OftenMissYi/Underwater-Robot-STM32F429/docs/project-presentation.pdf

# 水下四旋浆机器人

答辩人：赵珈毅 | 指导老师：刘富樯

2024

### 机器人工程专业

专业：机器人工程

组长：洪伟煌 组员：赵珈毅 罗成富 邢树超 夏威

C O N T A N T S

目 录

01 选题背景和意义 | 02 机器人结构设计
03 机器人电控系统设计 | 04 成果展示与未来展望

# 01 选题背景和意义

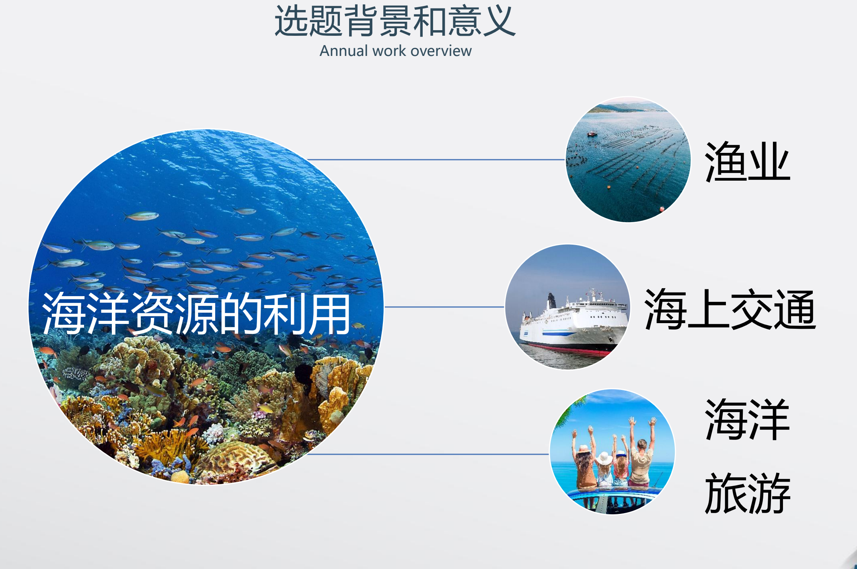
[picture p23: figure]
选题背景和意义; Annual work overview; 海洋资源的利用; 海上交通
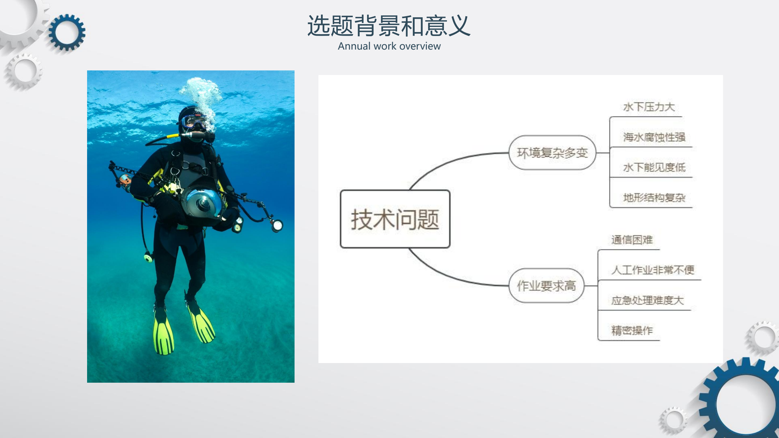
[picture p24: page 5]

选题背景和意义

Annual work overview

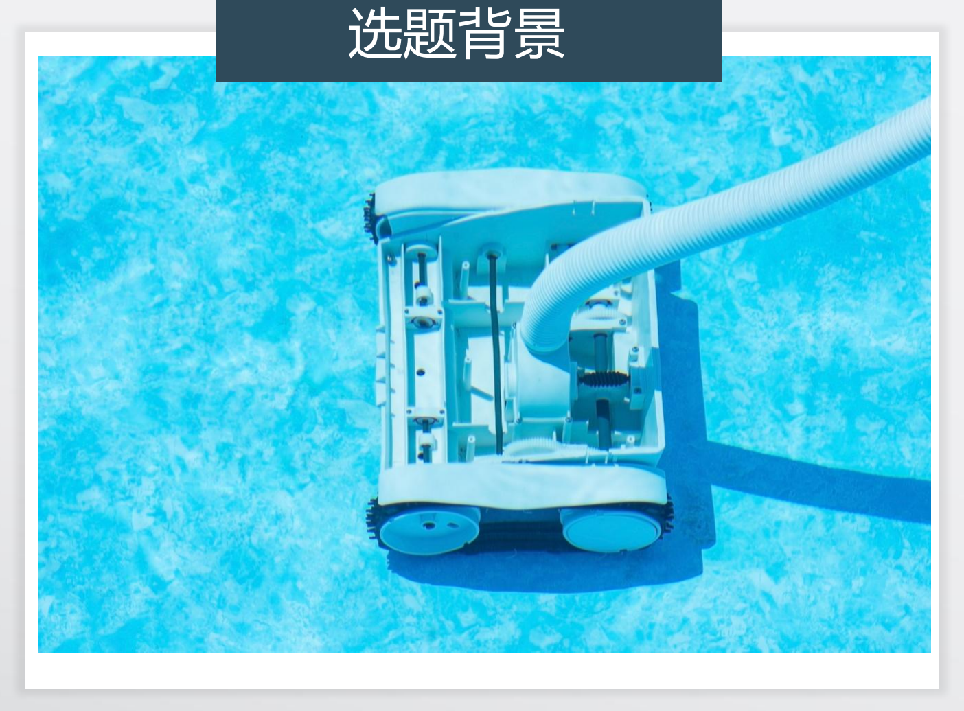
[picture p25: figure]
选题背景

小型水下机器人是一种用于水下极
限作业的机器人，具备在狭小空间
内灵活作业的能力。

因此，小型水下机器人在人机协同
作业、复杂环境勘探、水下集群作
业等方面具有充分优势。

选题背景和意义

Annual work overview

本组旨在开发一种小型拖缆式水下
机器人，以应对海下环境复杂多变
对水下作业提出的诸多挑战。

小型拖缆式水下机器人结合了自主
导航和拖缆控制技术，具有高度的
灵活性和适应性.

选题背景和意义

Annual work overview
水下机器人所面临的工作环境极为恶劣，这些环境特性对机器人的设计、 制造和维护都提出了严峻的挑战。水下机器人的设计应考虑以下因素：

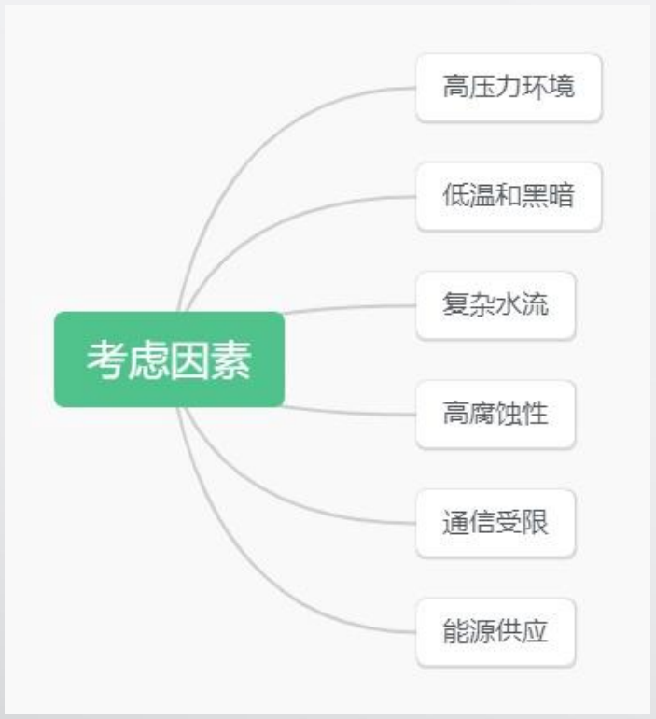
[picture p26: figure]

# 02 机器人结构设计

机器人机构设计

Robot mechanism design

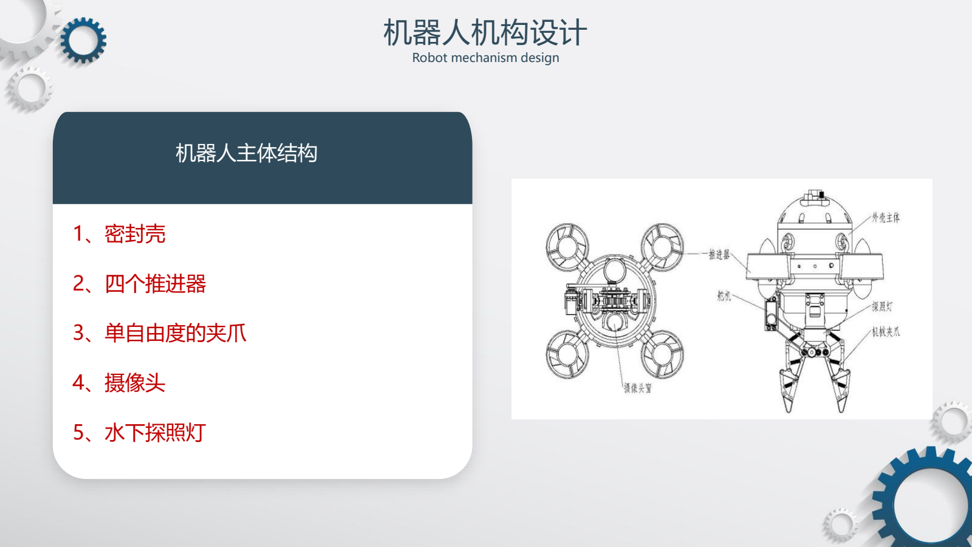
[picture p27: page 10]

机器人主体结构

1、密封壳

2、四个推进器

3、单自由度的夹爪

4、摄像头

5、水下探照灯

添加您的文字内容

机器人机构设计

Robot mechanism design

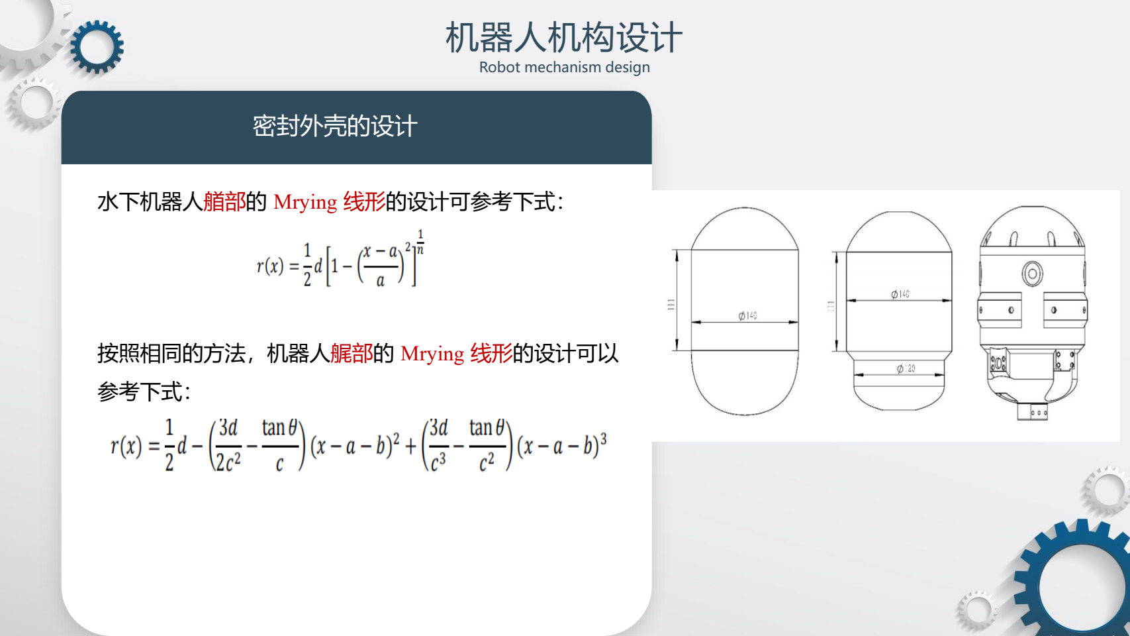
[picture p28: page 11]

密封外壳的设计

水下机器人艏部的 Mrying 线形的设计可参考下式：

按照相同的方法，机器人艉部的 Mrying 线形的设计可以 参考下式：

添加您的文字内容

机器人机构设计

Robot mechanism design

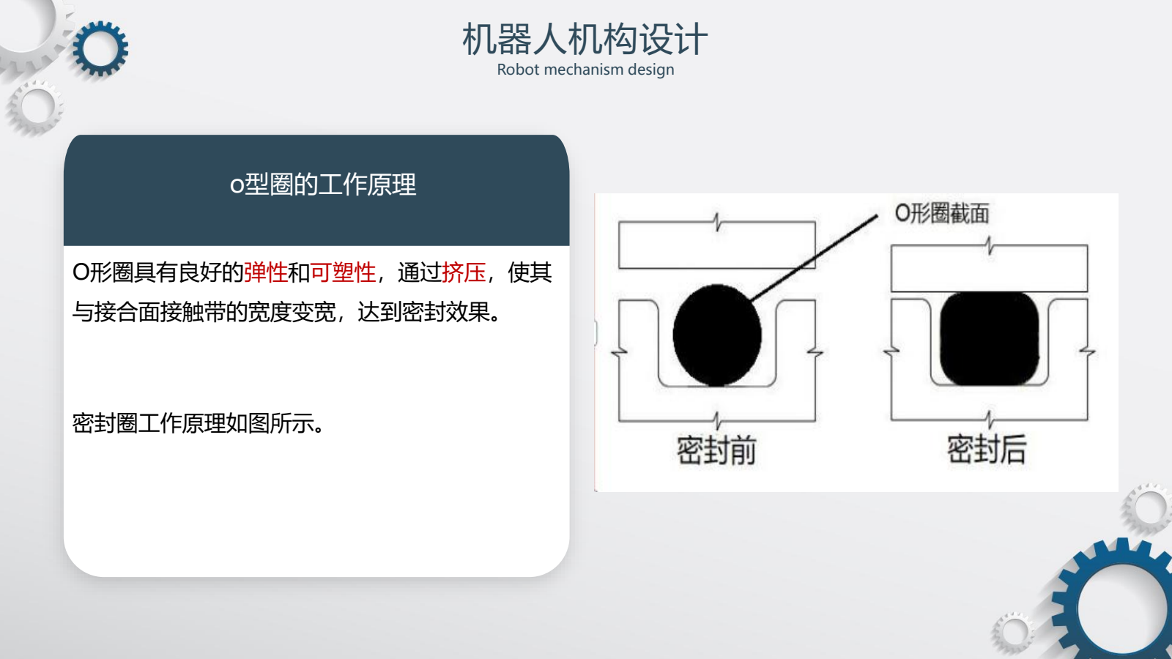
[picture p29: page 12]

o型圈的工作原理

O形圈具有良好的弹性和可塑性，通过挤压，使其
与接合面接触带的宽度变宽，达到密封效果。

密封圈工作原理如图所示。

添加您的文字内容

机器人机构设计

Robot mechanism design

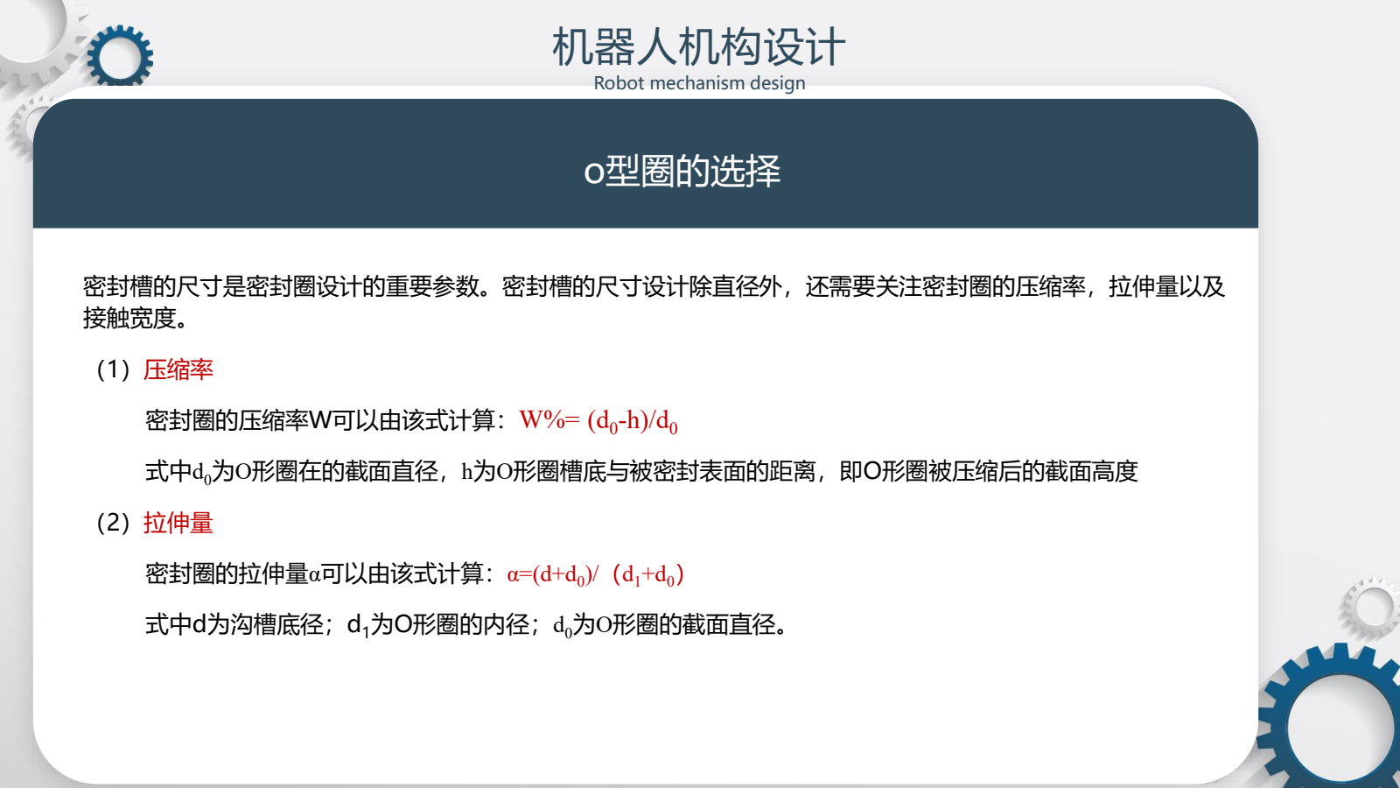
[picture p30: page 13]

o型圈的选择

密封槽的尺寸是密封圈设计的重要参数。密封槽的尺寸设计除直径外，还需要关注密封圈的压缩率，拉伸量以及 接触宽度。

（1）压缩率

密封圈的压缩率W可以由该式计算：W%= (d0
-h)/d0

式中d0为O形圈在的截面直径，h为O形圈槽底与被密封表面的距离，即O形圈被压缩后的截面高度

（2）拉伸量

密封圈的拉伸量α可以由该式计算：α=(d+d0
)/（d1+d0）

式中d为沟槽底径；d1为O形圈的内径；d0为O形圈的截面直径。

机器人机构设计

Robot mechanism design

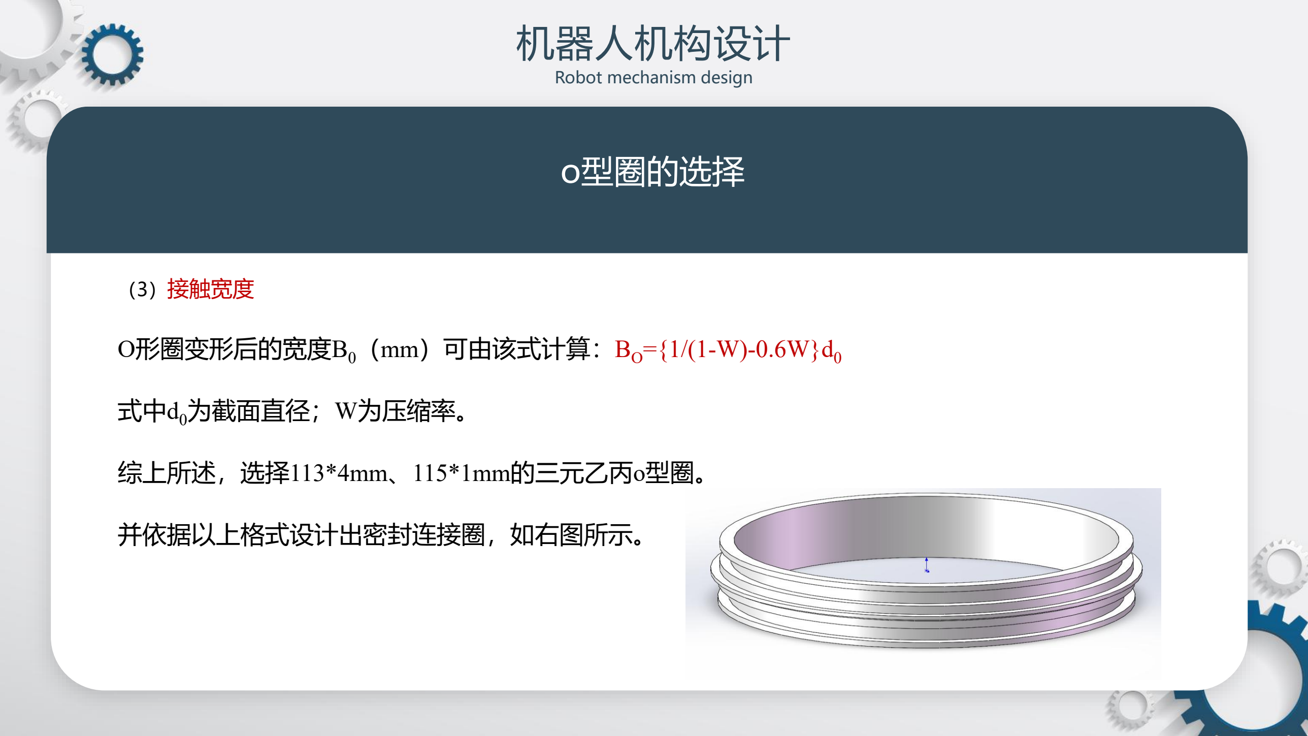
[picture p31: page 14]

o型圈的选择

（3）接触宽度

O形圈变形后的宽度B0（mm）可由该式计算：BO={1/(1-W)-0.6W}d0

式中d0为截面直径；W为压缩率。

综上所述，选择113*4mm、115*1mm的三元乙丙o型圈。

并依据以上格式设计出密封连接圈，如右图所示。

机器人机构设计

Robot mechanism design

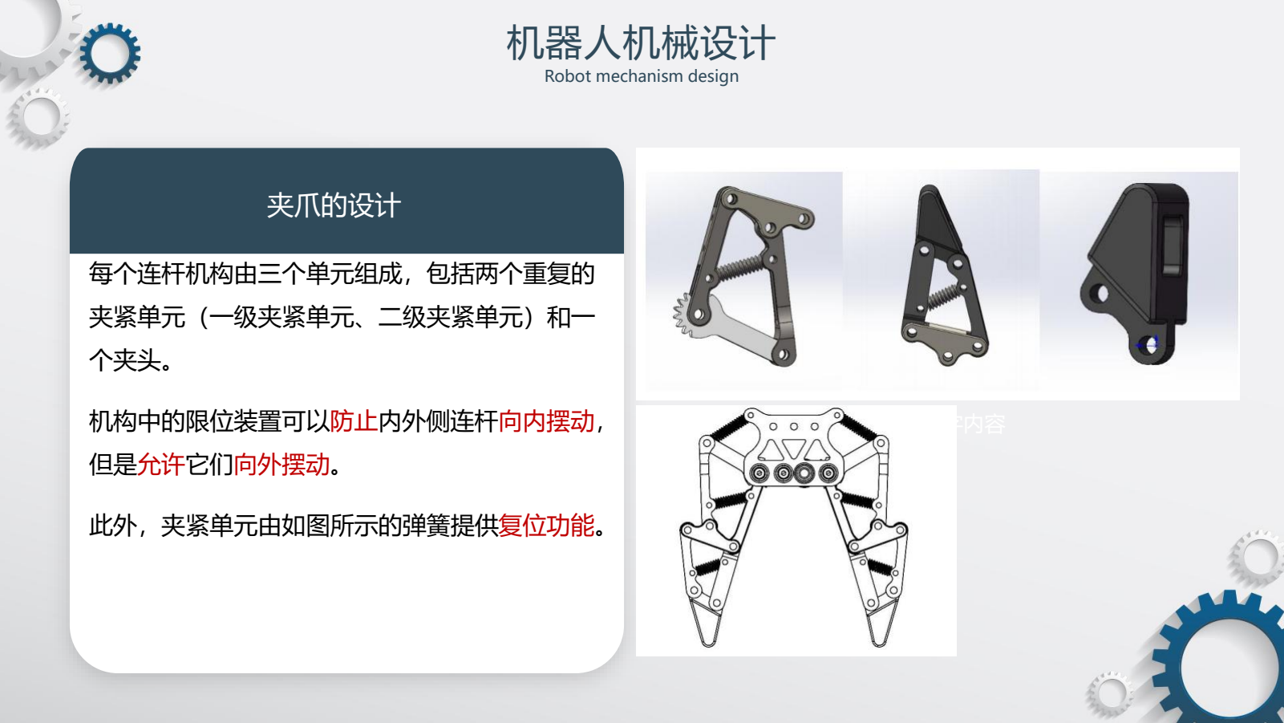
[picture p32: page 15]

夹爪的设计

每个连杆机构由三个单元组成，包括两个重复的
夹紧单元（一级夹紧单元、二级夹紧单元）和一
个夹头。

机构中的限位装置可以防止内外侧连杆向内摆动，
但是允许它们向外摆动。

此外，夹紧单元由如图所示的弹簧提供复位功能。

添加您的文字内容

机器人机械设计

Robot mechanism design

# 03 机器人电控系统设计

## 机器人电控系统设计

引言：

该电控系统首先接收用户上位机提供的运动、夹取等控制指令，接着对这些 指令进行解算，得出机器人工作设备的运行状态，再将这些运行状态转化为 控制信号，对工作设备进行控制。

同时，电控系统将机器人摄像头和传感器采集到的数据反馈给用户。

同时，电控系统还包括机器人电气设备和工作装置的能源供应系统，满足机 器人运行的能源需求。

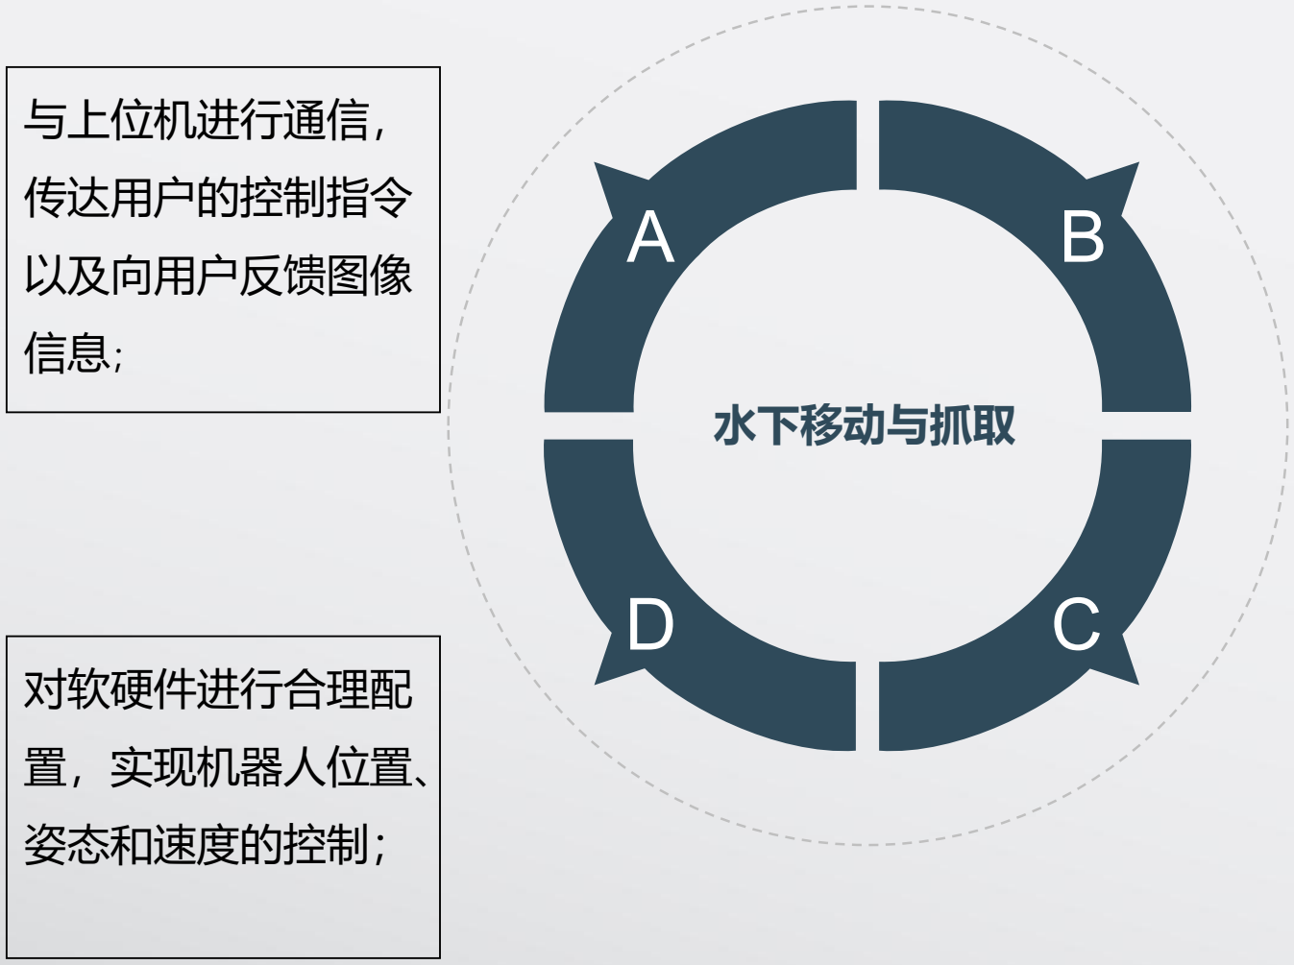
[picture p33: figure]
水下移动与抓取; 与上位机进行通信，; 传达用户的控制指令; 以及向用户反馈图像; 对软硬件进行合理配; 置，实现机器人位置、; 姿态和速度的控制；

满足对机械手的开合
控制，实现夹取功能；

合理配置电源系统，
保证续航能力。

电控系统设计目标和思路

采用有线供电，通过变
压器将48V 直流 电转
化为机器人设备的可用

的 24V 电源；

配置电源系统

基于STM32cubeMX和
keil5完成机器人控制代
码，用遥控器对机器人
进行控制；

运动控制

c板接收用户的控制指
令，再由 MCU 控制单
元生成控制指令控制舵
机运行；

机械手控制

01 | 02 | 03

电控系统的设计

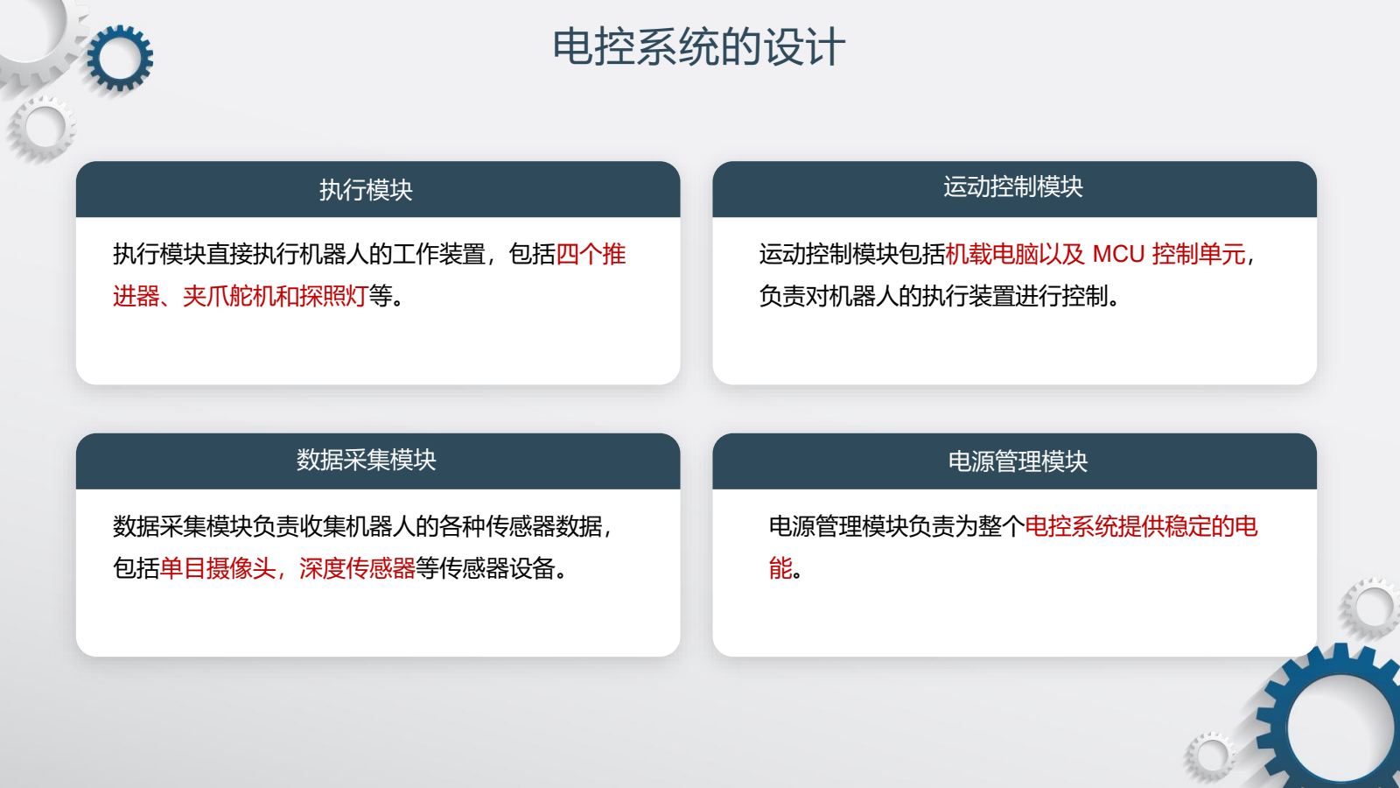
[picture p34: page 20]

执行模块

执行模块直接执行机器人的工作装置，包括四个推
进器、夹爪舵机和探照灯等。

运动控制模块

运动控制模块包括机载电脑以及 MCU 控制单元，
负责对机器人的执行装置进行控制。

数据采集模块

数据采集模块负责收集机器人的各种传感器数据，
包括单目摄像头，深度传感器等传感器设备。

电源管理模块

电源管理模块负责为整个电控系统提供稳定的电
能。

电控系统的设计

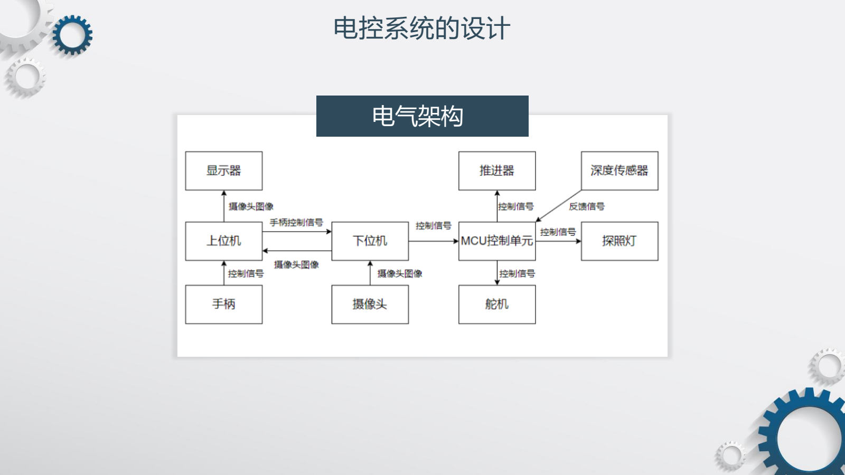
[picture p35: page 21]

电气架构

电控系统的设计

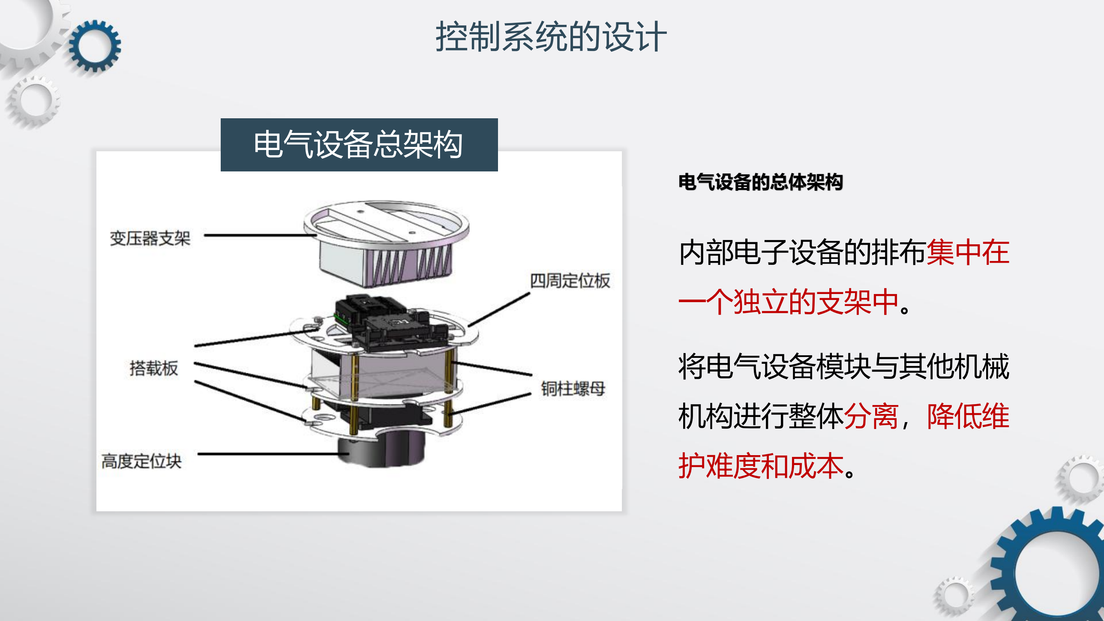
[picture p36: page 22]

电气设备总架构

内部电子设备的排布集中在
一个独立的支架中。

将电气设备模块与其他机械
机构进行整体分离，降低维
护难度和成本。

电气设备的总体架构

控制系统的设计

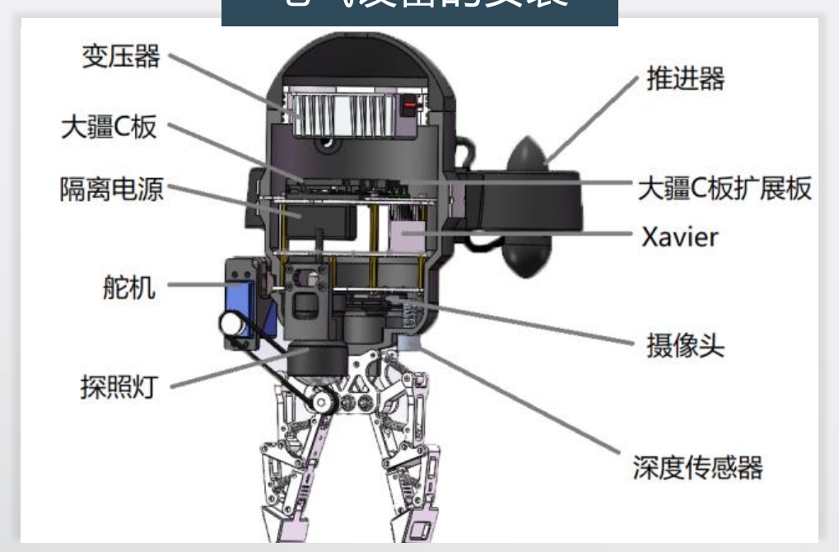
[picture p37: figure]

电气设备的安装

采用注塑螺母的区域对壳体
进行了加厚，避免壳体强度
下降。该支架通过磁力弹簧
以及铰链结构实现张紧。

外部设备的安装

控制系统的设计

系统架构 | 运动解算逻
| 辑的实现
01 | 02

# 控制系统的设计

## 系统架构

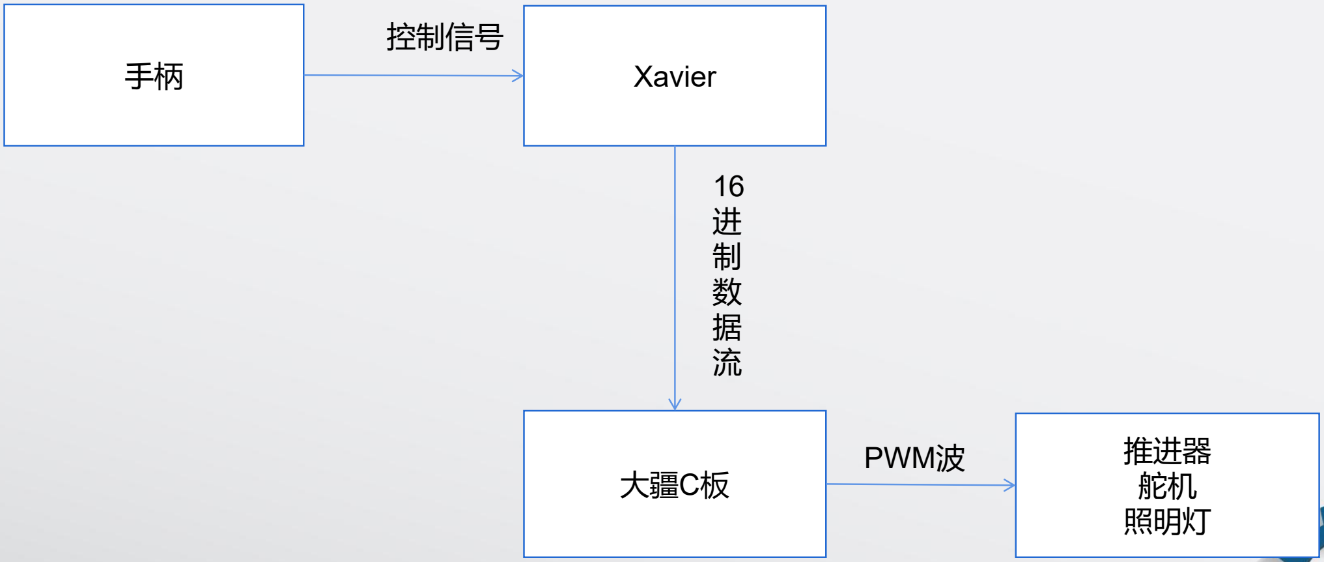
[picture p38: figure]
Xavier; 推进器 舵机 照明灯; 控制信号; 16进制数据流; PWM

## 运动解算逻辑的实现

机器人的底层控制主要有四个方面，位置控制、姿态控制、控制分配和电机控制。该控制逻 辑的实现采用四旋翼无人机飞控程序，该程序通过 PWM 信号进行控制，内置 PID 算法，依靠陀 螺仪进行自稳。该程序可以解析机器人的运动信号并将其转化成控制推进器的 PWM 信号。 此外还具备控制舵机以及探照灯的功能。控制信号的传递依靠 Xavier 进行，基于 ROS 系统 对手柄的控制信号进行读取，并生成 PWM 信号传输至 C 板。此外，Xavier 具备桌面系统，用 户通过局域网远程桌面对摄像头的视频信息进行监视。

# 04 成果展示与未来展望

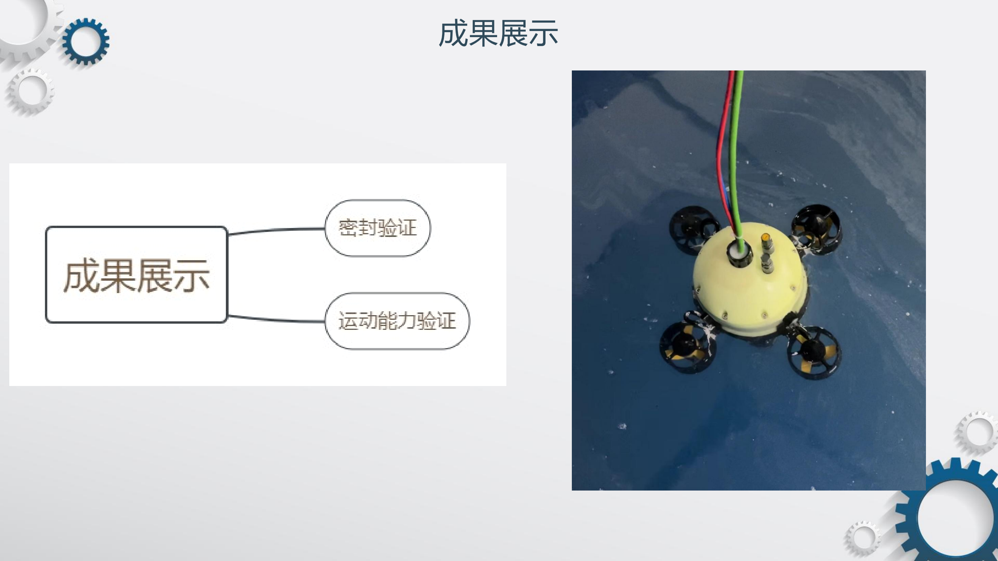
[picture p39: page 28]

成果展示

密封验证

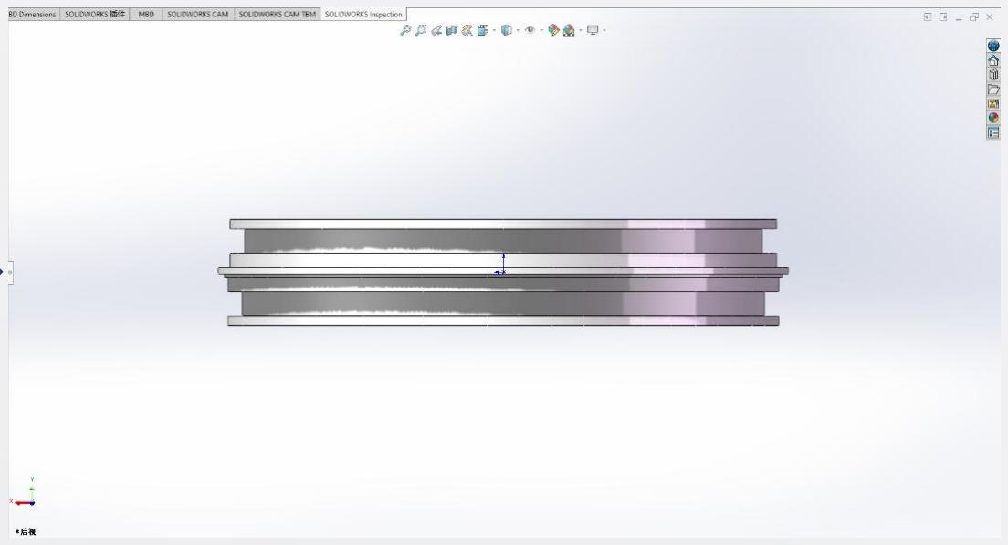
[picture p40: figure]
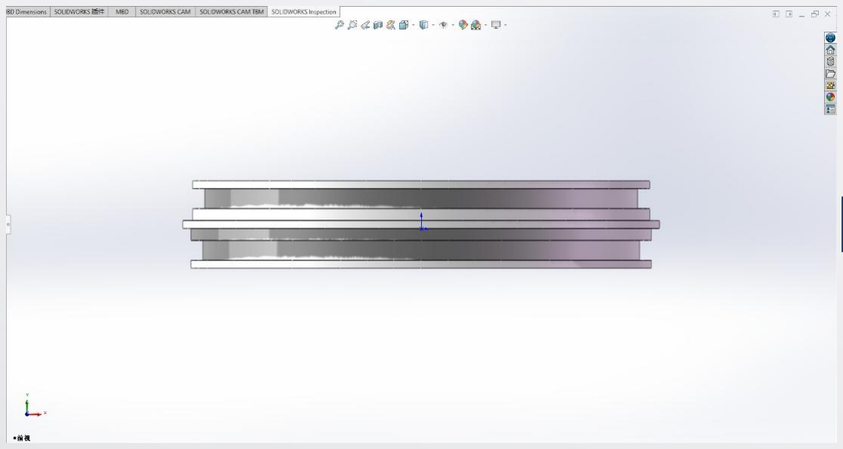
[picture p41: figure]

## 壳体连接处进行结构修改，O型圈重新设计尺寸

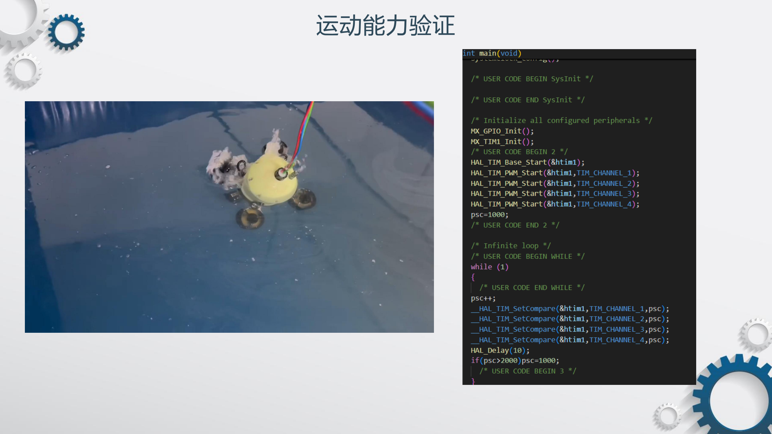
[picture p42: page 30]

运动能力验证

未来展望

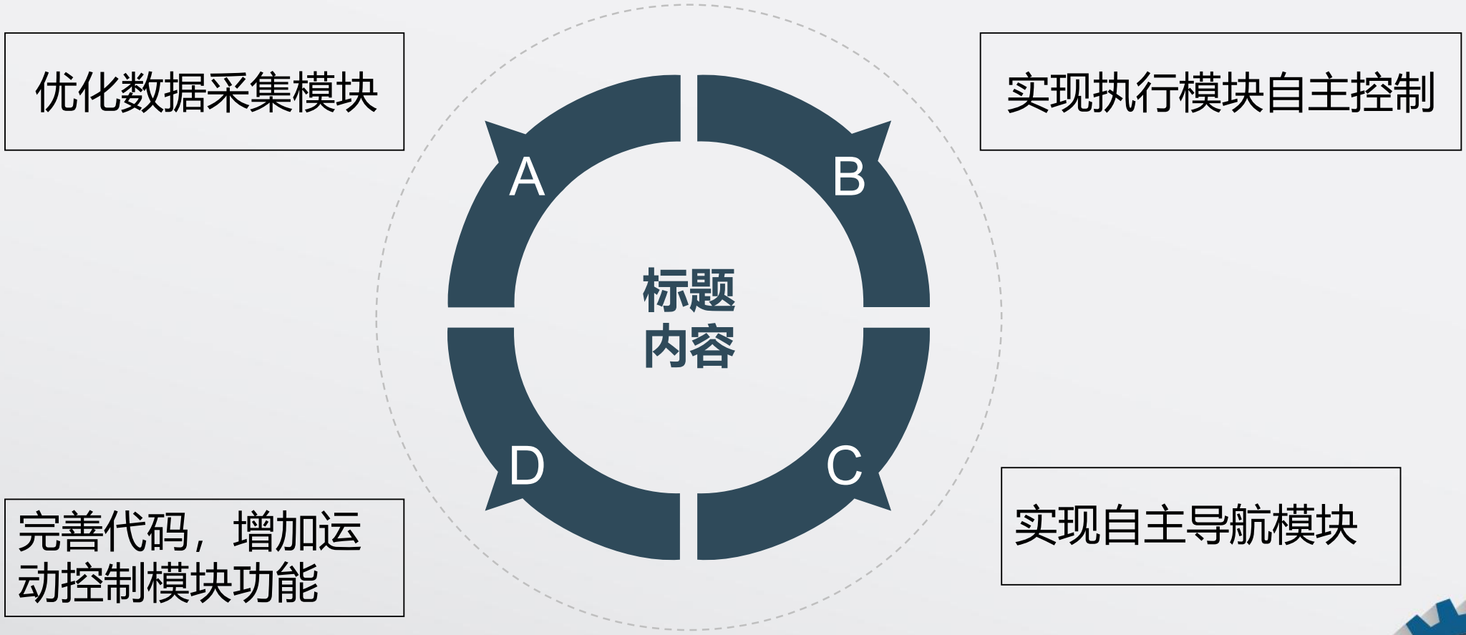
[picture p43: figure]
优化数据采集模块; 完善代码，增加运 动控制模块功能; 实现自主导航模块; 实现执行模块自主控制

# 汇报完毕

# 敬请各位老师批评指正

答辩人：赵珈毅 | 指导老师：刘富樯

组长：洪伟煌 组员：赵珈毅 罗成富 邢树超 夏威
