OftenMissYi/Underwater-Robot-STM32F429/AUTO/auto_pid.c

#include "auto_pid.h"
#include "math.h"
#include "pid.h"

float K_Angel_Speed[6] = {0.3,0.3,0.3,0.1,0.1,0.1}; //角度想转得快就设大,分别为滚转，俯仰，偏航，深度Z，X，Y

float X_Y[101] = {
-0.997527,-0.996859,-0.99601,-0.994933,-0.993568,
-0.991837,-0.989646,-0.986875,-0.983374,-0.978959,
-0.973403,-0.966431,-0.95771,-0.946849,-0.933392,
-0.916828,-0.8966,-0.872139,-0.842905,-0.808455,
-0.768526,-0.723123,-0.672608,-0.617749,-0.559715,
-0.500001,-0.440288,-0.382253,-0.327394,-0.276879,
-0.231476,-0.191546,-0.157096,-0.127862,-0.103401,
-0.083173,-0.0666083,-0.0531513,-0.0422899,-0.0335694,
-0.0265971,-0.0210414,-0.0166264,-0.0131254,-0.0103538,
-0.00816261,-0.00643214,-0.00506665,-0.00398988,-0.00314123,
0,
0.00314121,0.00398987,0.00506663,0.00643211,0.00816257,
0.0103537,0.0131253,0.0166264,0.0210413,0.026597,
0.0335692,0.0422898,0.0531511,0.066608,0.0831727,
0.1034,0.127862,0.157096,0.191545,0.231475,
0.276878,0.327393,0.382252,0.440287,0.5,
0.559714,0.617748,0.672607,0.723122,0.768525,
0.808455,0.842905,0.872138,0.896599,0.916827,
0.933392,0.946849,0.95771,0.966431,0.973403,
0.978959,0.983374,0.986875,0.989646,0.991837,
0.993568,0.994933,0.99601,0.996859,0.997527
};

/*x属于[-1,1]，输入当前角度差和准备旋转时的角度差，输出期望角速度*/
float angel_speed(const float error_angel, const float max_error_angel, int i)
{
	float output;
	int x;
	if(error_angel < 0)
		x = (int)(50 * error_angel / max_error_angel) + 50;
	if(error_angel >= 0)
		x = (int)(50 * error_angel / max_error_angel) + 50;
	if(x < 0) x = 0;
	if(x > 100) x = 100;
	
	output = (K_Angel_Speed[i] * max_error_angel) * X_Y[x];
	
	return output;
}

/*算出PWM增量，输入期望角速度与当前角速度差*/
int PI_Calc(PidObject* pid, const float error_angel_speed) 
{
	int output; 
	pid->error = error_angel_speed;  
	output = (int)(pid->kp * pid->error - pid->kd * pid->prevError);	
	pid->prevError = pid->error;
	
	return output;
}
