OftenMissYi/Underwater-Robot-STM32F429/HARDWARE/PCF8574/pcf8574.h

#ifndef __PCF8574_H
#define __PCF8574_H
#include "sys.h"
#include "depth_iic.h"


#define PCF8574_INT  PBin(12) //PCF8574 INT脚

#define PCF8574_ADDR 	0X40	//PCF8574地址(左移了一位)

//PCF8574各个IO的功能
#define BEEP_IO         0		//蜂鸣器控制引脚  	P0
#define AP_INT_IO       1   	//AP3216C中断引脚	P1
#define DCMI_PWDN_IO    2    	//DCMI的电源控制引脚	P2
#define USB_PWR_IO      3    	//USB电源控制引脚	P3
#define EX_IO      		4    	//扩展IO,自定义使用 	P4
#define MPU_INT_IO      5   	//MPU9250中断引脚	P5
#define RS485_RE_IO     6    	//RS485_RE引脚		P6
#define ETH_RESET_IO    7    	//以太网复位引脚		P7

u8 PCF8574_Init(void); 
u8 PCF8574_ReadOneByte(void); 
void PCF8574_WriteOneByte(u8 DataToWrite);
void PCF8574_WriteBit(u8 bit,u8 sta);
u8 PCF8574_ReadBit(u8 bit);
#endif
