OftenMissYi/Underwater-Robot-STM32F429/HARDWARE/RS485/rs485.h

#ifndef __RS485_H
#define __RS485_H
#include "sys.h"

extern u8 RS485_RX_BUF[64]; 		//接收缓冲,最大64个字节
extern u8 RS485_RX_CNT;   			//接收到的数据长度
extern UART_HandleTypeDef USART2_RS485Handler;  //USART2句柄(用于RS485)
extern DMA_HandleTypeDef DMA1_InitStructure;     //DMA句柄

//如果想串口中断接收，设置EN_USART2_RX为1，否则设置为0
#define EN_USART2_RX 	1			//0,不接收;1,接收.
#define RECEIVE485_SIZE  128

void RS485_Init(u32 bound);
void RS485_Send_Data(u8 *buf,u8 len);
void RS485_Receive_Data(u8 *buf,u8 *len);	
void RS485_TX_Set(u8 en);

#endif
