OftenMissYi/Underwater-Robot-STM32F429/SYSTEM/usart/usart.h

#ifndef _USART_H
#define _USART_H
#include "sys.h"
#include "stdio.h"	
#include "Servo.h"
//////////////////////////////////////////////////////////////////////////////////	 

////////////////////////////////////////////////////////////////////////////////// 	
#define USART_REC_LEN  			200  	//定义最大接收字节数 200
#define EN_USART1_RX 			1		//使能（1）/禁止（0）串口1接收
	  	
extern u8  USART_RX_BUF[USART_REC_LEN]; //接收缓冲,最大USART_REC_LEN个字节.末字节为换行符 
extern u16 USART_RX_STA;         		//接收状态标记	
extern UART_HandleTypeDef UART1_Handler; //UART句柄
void USART_PWM(void);

#define RXBUFFERSIZE   128 //缓存大小
extern u8 aRxBuffer[RXBUFFERSIZE];//HAL库USART接收Buffer

//如果想串口中断接收，请不要注释以下宏定义
void uart_init(u32 bound);




#endif
